dorkusprime/miata-remote-control-knob/hardware/sony-remote/pad-map.md

# Sony interface pad allocation

The [component placement image](placement-full.svg) shows the top and horizontally mirrored underside. See the [bench results](../../docs/bench-results-2026-11-05.md) for observed hardware behavior and the [circuit guide](../../docs/sony-interface.md) for installation limits.

## Component terminals

| Ref | Part / side | Terminal → pad |
| --- | --- | --- |
| U1 | MCP41050-I/P / top | 1 → E1, 2 → E2, 3 → E3, 4 → E4, 8 → F1, 7 → F2, 6 → F3, 5 → F4 |
| U2 | SN74HCT125N / top | 1 → E6, 2 → E7, 3 → E8, 4 → E9, 5 → E10, 6 → E11, 7 → E12, 14 → F6, 13 → F7, 12 → F8, 11 → F9, 10 → F10, 9 → F11, 8 → F12 |
| K1 | LCC110 / top | 1 → E14, 2 → E15, 3 → E16, 4 → E17, 8 → F14, 7 → F15, 6 → F16, 5 → F17 |
| Q1 | 2N3904BU / top | E → B12, B → B13, C → B16 |
| R1 | 330 ohm / top | 1 → C15, 2 → F13 |
| R2 | 1 kohm / top | 1 → A5, 2 → A13 |
| R3 | 2.7 kohm / top | 1 → J5, 2 → J17 |
| R4 | 47 kohm / top | 1 → C7, 2 → C6 |
| R5 | 47 kohm / top | 1 → C10, 2 → C9 |
| R6 | 47 kohm / top | 1 → H11, 2 → H10 |
| R7 | 47 kohm / top | 1 → C13, 2 → C12 |
| C1 | 100 nF / top | 1 → J1, 2 → J4 |
| C2 | 100 nF / top | 1 → I6, 2 → I10 |
| C3 | 10 uF / top | + → J6, - → J10 |
| R8 | 47 kohm / top | 1 → H8, 2 → H7 |
| R9 | 47 kohm / top | 1 → G9, 2 → G7 |

## Underside header pins

J1 lands in columns B and I; J2 lands in column H. Insert header pins from underneath and solder their tails from the top. Use individual pins at spaced pads and a two-pin header at H4–H5. Use the [consolidated jumper image](../internal-jumpers.svg) for the seven J1 wires to the XIAO breakout. J1.7 at B9 is spare ground. Sony Input 2 stays insulated.

| Contact | Net | Pad |
| --- | --- | --- |
| J1.1 | GND | B4 |
| J1.2 | +5V | I1 |
| J1.3 | SCK_IN | B10 |
| J1.4 | MOSI_IN | I11 |
| J1.5 | CS_IN | B7 |
| J1.6 | RELAY_EN | B5 |
| J2.1 | SONY_IN | H5 |
| J2.2 | GND | H4 |
| J1.7 | GND | B9 |
| J1.8 | CAMERA_REQUEST | I8 |
| J2.3 | CAMERA_BUFFER | H9 |

## Camera output cable

J2.3 at H9 is the buffer output. Insert R10 (1 kohm) in series in this pigtail, sleeve both joints and the resistor, then connect to EXT IN 1. R10 is outside the board geometry model. Never connect this lead to vehicle 12 V.

## Underside wire pieces and bus taps

Crossings are not junctions. Use insulated wire; route clear of resistor bodies and keep leads sleeved over unrelated pads. Coordinates are endpoint and routing references, not validated three-dimensional wire bends.

| Wire | Net | Solder pads in order |
| --- | --- | --- |
| BG1 | GND | C4 → G4 |
| BG2 | GND | D4 → D6 |
| BG3 | GND | A6 → A9 |
| BG4 | GND | D9 → A12 |
| BG5 | GND | D12 → G10 |
| BG6 | GND | B6 → I7 |
| BV1 | +5V | G1 → H6 |
| BV2 | +5V | G6 → G13 |
| W10 | CS_OUT | A1 → A8 |
| W11 | SCK_OUT | B2 → B11 |
| W12 | MOSI_OUT | C3 → J12 |
| W13 | PW | H3 → G16 |

Use one insulated through-hole jumper per listed pair. Each end has its own hole.

## Assembly and physical conditions

- Fit sockets and top components first, without solder. The IC-only image is now a subset of this candidate.
- R1 and R4–R8 stand upright. R1 is at C15 and its sleeved return lead follows the gap between U2 and K1 to F13. The power bus now ends at G13. This is a formed-lead proposal, not a validated socket clearance or guaranteed supplied lead length.
- Q1 has a formed-lead footprint, not the default three adjacent TO-92 holes. E=B12, B=B13, C=B16. Q1 moves to the lower-left corner; R7 runs straight along C12–C13. Check the actual part orientation and preform without force at the body.
- All component bodies are now on top. R2 follows the top left edge; R3 follows the top right edge with a jog to x=37 mm past C3. Sleeve extended leads and dry-fit before trimming.
- Check supplied lead lengths before trimming. If a lead cannot follow its proposed route safely, revise the model or use an insulated extension; do not force the component.
- C1/C2 leads are spread to the listed pads, rather than matching the stock 2.5 mm lead pitch. Avoid stress at the ceramic coating. C3 is polarized.
- Body envelopes are provisional. The resistor envelope allows 6.8 × 2.6 mm, based on Yageo MFR-25 maximum body dimensions. Socket outlines, capacitor lead availability, mounting-hole locations and assembled height still require actual measurements.
- All component bodies are on top; only the 12 wire pieces and solder joints are underneath. Distributed pigtails preserve the no-cut board. Mounted height and center mounting-hole access remain unverified.
- On the actual board, verify A–E / F–J strip continuity and orientation first. Do not solder until the dry-fit and receiver-disconnected electrical checks pass.

## Verification scope

`python3 scripts/full-placement.py --check` verifies the 16 board component references, terminal connectivity against an independent device-pin contract, all resistor values, factory strips, no accidental net joins, no reused holes, pigtail assignments, nominal body separation, all-top component placement, orthogonal routes, and all component-lead routes avoiding other component bodies. It also verifies that the SVG/table match the model. This is not a timing, analog-current, power-sequencing or physical-fit simulation.

Regenerate with `python3 scripts/full-placement.py`. Tests deliberately introduce a rail short, an open jumper, a transistor-pin swap, pad reuse, a resistor-value error, a body overlap a missing bus tap, a diagonal wire, and a component lead crossing another body.

Source for resistor envelope: [Yageo MFR datasheet, dimensions](https://yageogroup.com/content/datasheet/asset/file/YAGEO-MFR_DATASHEET). Other envelopes are conservative drawing assumptions, not new manufacturer guarantees.
