dorkusprime/miata-remote-control-knob/docs/tasks.md

# Development checklist

## Workspace

- [x] Verify local commits, GitHub push, remote branch, and clean working tree (2026-10-26).
- [x] Choose and pin a firmware toolchain/core and Twist library (see firmware/toolchain.json; 2026-10-27).
- [x] Confirm XIAO USB enumeration (Seeed XIAO RP2040, /dev/cu.usbmodem1412301; 2026-10-27).
- [x] Compile serial-only diagnostic for XIAO; no compiler warnings (2026-10-27).

## Encoder diagnostics and follow-up: Sony disconnected

Initial functional diagnostic complete: USB/I2C, rotation, button, RGB, and repeated Picotool uploads are verified by user observations. Gesture implementation and installation checks remain separate.

- [ ] Dry-fit headers, cable plugs, and enclosure clearances.
- [ ] Verify wiring continuity and absence of shorts while unpowered.
- [x] User uploaded the first serial diagnostic via BOOT-mode UF2 copy (2026-10-27).
- [x] User uploaded and tested diagnostic v2; rotation/buttons/held rotation confirmed in supplied serial output.
- [x] Build Picotool-enabled firmware and add build/upload helper (2026-10-27).
- [x] User installed Picotool-enabled build; subsequent Picotool uploads succeeded (2026-10-27).
- [x] User confirmed two successive USB uploads without button access or unplugging (2026-10-27).
- [x] Verify Twist at 0x3F: working v2 snapshot reads require that address and expected device ID. A separate scan transcript was not supplied.
- [x] Button DOWN/UP events observed by user (2026-10-27).
- [x] V2 reads rotation in both directions and while pressed (user serial output; 2026-10-27). Original diagnostic failure cause remains unconfirmed.
- [x] User reports RGB diagnostic tests worked after r/g/b/o test instructions (2026-10-26, client local date).
- [x] Preserve original diagnostic; implement separate gesture controller with serial-only command output.
- [x] Add live translated monitor with port detection and reconnection.
- [x] Pass 19 host gesture scenarios and 15 monitor tests, including virtual serial testing (2026-10-26 client local date).
- [x] User uploaded controller and reports all gestures functional through the live monitor (2026-10-26 client local date).
- [x] Implement full-brightness idle blue and nonblocking gesture LED feedback, including camera acknowledgement pulse only.
- [x] Pass 10 LED scenarios and compile controller v2 (2026-10-26 client local date).
- [x] User uploaded LED build and reports all feedback working (2026-10-26 client local date).
- [ ] Confirm repeat Picotool uploads with the controller sketch.

## Sony interface

- [x] User powered Sony successfully from bench supply at nominal 12 V (2026-10-28).
- [ ] Record supply model/rating, current limit, startup current and loaded voltage; previous supply-collapse cause unknown.
- [x] Included steering-remote adapter is on hand: Input 1, Input 2, ST Remote GND (user observation recorded 2026-10-27).
- [ ] Confirm adapter model and which remote input to use; verify plug-contact mapping if needed.
- [x] Measure remote input unloaded and with known load: approximately +3.3 V, 9.86 kohm load, 2.939 V loaded (2026-10-28).
- [x] Record actual steering-learning menu: ten functions including Mute, no camera assignment; see bench report.
- [ ] Test passive resistor commands/learning; a loaded voltage measurement is not command recognition.
- [x] Archive five-relay ladder; select one LCC110 plus digital pot (user direction, 2026-10-27).
- [x] Select MCP41050-I/P + SN74HCT125N + existing LCC110 and NPN driver; all through-hole.
- [x] Document pin-level circuit, current limits, harness, calibration and acceptance procedure.
- [x] User ordered DigiKey components, including intentional spares (2026-10-27).
- [x] Consolidate active docs and archive superseded build instructions.
- [x] Choose a small soldered protoboard near the Sony (prior user decision).
- [x] Receive parts and assemble permanent board; replaced defective LCC110 after diode comparison.
- [x] Add a provisional current-design DIP placement image with pin/net reference; not a complete routed layout.
- [x] Place every component and pigtail in a complete proposed pad map; document top / underside views and check all nets, holes and nominal body separation.
- [x] Simplify placement: all component bodies on top, with two tapped buses and four signal wires underneath; all drawn lead and wire routes orthogonal.
- [ ] Dry-fit actual components, sockets, mounting holes, formed leads and bus construction; verify insulation, clearances and overall height.
- [x] Assemble permanent board; user verified rails, continuity corrections and relay LED current.
- [x] Implement interface diagnostic; user verified GPIO outputs and pot codes 64/128/192.
- [x] Measure and record all six calibrated output resistances with Sony disconnected.
- [ ] Validate simulated-input current, reset/fault behavior and both supply-loss orders.
- [x] Estimate Sony source impedance from user measurements: about 1.1–1.2 kohm; see bench report.
- [x] Replace the colliding initial profile with the final Sony-learned codes 0, 215, 230, 238, 248 and 255. The measured minimum is 3.047 kΩ at code 255. Endpoint current remains open.
- [x] Verify Sony learning and recognition of all six final commands at the final normal pulse timing.
- [ ] Validate final cable length, connector orientation, mounting and strain relief.
- [ ] Repeat electrical acceptance after permanent assembly.
- [x] Implement controller v3 bounded pulse queue, fault release, watchdog and real requests; host-tested/compiled.
- [x] User uploaded v4.0 and verified the integrated knob and Sony functions.
- [ ] Repeat software-only uploads through the enclosure panel jack, including after cold startup.

## Camera and installation

Required scope: [Camera 1 hardware/firmware plan](camera-control.md).

- [x] Integrate spare HCT125 camera channel, R8/R9 pull-downs and inline R10 into checked layout/BOM/docs.
- [x] Route D2/GPIO28 through internal J1.8 to the buffer and external P1.7 to EXT IN 1. P1.8 is reserved for D3.
- [ ] Verify final connector orientation and cable fit in the vehicle.
- [x] Implement camera-request backend and host fault-release tests.
- [x] Verify external-source EXT IN 1 assertion and release to previous screen (2026-10-28).
- [ ] Test touchscreen Back/retrigger and repeat release with actual buffer.
- [ ] Provide camera power during manual preview, independent of reverse-lamp-only power.

- [ ] Identify actual camera/DVR model and supply requirements.
- [x] User confirmed Camera 1 without camera-generated lines, rear input with Sony guidelines, and reverse priority in sequential-input bench test (2026-10-28).
- [x] User tested passive RCA split: reverse with lines and Camera 1 without lines, switching successfully with no reported image-quality degradation (2026-10-31).
- [x] User verified external 5 V/resistor Camera 1 trigger assertion/release, live picture, and reverse priority (2026-10-28).
- [x] Verify the assembled buffer drives manual Camera 1 on/off and Sony reverse overrides it.
- [x] Verify normal cold startup on the 12 V bench supply with the laptop unplugged.
- [ ] Measure loaded trigger voltage/current and record reverse-exit screen with a standing manual request.
- [ ] Measure lighter opening and rear clearance.
- [ ] Finalize mechanical support, power protection, and strain relief.

## Bench evidence and next session

The [November 12 bench record](bench-results-2026-11-12.md) is the current status and links the earlier measurements and fixes. The milestones below preserve the development history, including test plans that later versions superseded.

## Historical implementation milestone — 2026-11-06

See [assembled bench results](bench-results-2026-11-05.md) and [controller v3 workflow](gestures.md). Historical checklist descriptions above are evidence of earlier plans, not a reason to repeat already completed strip-continuity tests. At that stage, Sony learning, integrated physical behavior and power-loss acceptance were open.

## Learning mode — 2026-11-06

- [x] User uploaded integrated controller and reported knob/LED operation working.
- [x] Implement ten-second knob hold entry/exit, LED flash feedback and three-second learning holds; host testing and compile recorded in gestures.md.
- [ ] User uploads v3.2 and verifies Sony Custom learning/recognition; 55 ms learning attempt did not register.

## Current Sony calibration — 2026-11-06

- [x] User confirms Sony distinguishes code 0 / Volume Down and code 255 / Volume Up.
- [x] Restore three interior steering candidates spaced by estimated input voltage, retaining both endpoint codes.
- [x] Add RAM-only serial assignment changes and raw six-second probes; no reflashing needed per trial.
- [ ] User uploads v3.4 and tests Mute first, then Next/Previous; record distinct/colliding/ignored responses.
- [ ] Map recognition boundaries relative to learned assignments and establish the usable number of distinct commands.
- [ ] Verify ordinary short-pulse operation for accepted commands, repeat software upload after cold startup, and complete power-transition acceptance.

This current status supersedes older pending endpoint and initial learning-mode upload items; those historical entries retain their original context.

## USB host compatibility — 2026-11-06

- [x] Research upstream reset failures through their resolution and inspect actual local tool/library versions.
- [x] Replace macOS uploader dependency Picotool 2.0.0/libusb 1.0.27 with pinned official 2.3.1/1.0.30 bundle; no firmware change or agent flash.
- [ ] User retries upload with the corrected host bundle, then repeats after successful programming; actual software-reset reliability remains unverified.

## Standard upload baseline — 2026-11-06

- [x] Record that Picotool/libusb upgrade alone did not resolve the user's failed software reset (zero-byte status response).
- [x] Replace custom upload orchestration with Arduino CLI's core-provided Picotool recipe; retain memory reporting and explicit port selection.
- [ ] User verifies initial, repeat and post-power-cycle upload without pressing BOOT. This is required before burial behind the console fascia.

## Sony learning progress — 2026-11-06

- [x] User confirms v3.4 loaded and three commands functional: Volume - (0), Play/Pause via single press (238), Volume + (255).
- [x] User taught Next Track via held right turn (248) and Previous Track via held left turn (215); all five commands work.
- [x] Stop capacity exploration at user request: nine codes accepted, ample capacity for six requested audio commands. Maximum remains unknown.

## Final requested controls — controller v3.5

- [x] Preserve Volume +/-, Play/Pause, Next/Previous and separate Camera 1 double-click output.
- [x] Add stationary hold/release Mute using Sony-accepted code 230; distinguish `play_pause` from `mute_att` in firmware and monitor.
- [ ] User uploads v3.5 and verifies hold/release Mute, other gestures and Camera 1 operation. Existing Sony assignments can remain.
- [ ] Complete reliable software upload and power-transition acceptance before installation.

## Knob responsiveness — v3.6

- [x] Identify measured fast-roll drops as firmware queue-capacity and age-expiry policy, not button debounce.
- [x] Preserve consecutive volume detents using counted runs; user trace confirms all 17 steps transmitted.
- [x] Add RAM-only normal pulse/gap timing adjustment and retain output timestamp diagnostics.
- [ ] Test shorter pulses against Sony, starting with `timing 25 25` and one detent, then tune for usable fast-roll response. Default remains 55/55 until a faster rate is validated.

## Live-volume candidate — v3.7

- [x] Record unacceptable counted-FIFO lag at 55/10 and missed Sony commands at 25/10.
- [x] User verifies Sony repeats volume during a six-second held command.
- [x] Implement slow-detent taps plus rapid-turn holds with 100 ms idle release and reversal cancellation; host tests and build pass.
- [ ] User verifies slow-step precision, short fast-roll usefulness, prompt stopping and reversals on Sony. Initial receiver repeat delay remains unmeasured.

## Coarse fast-flick candidate — v3.8

- [x] Record that a 188 ms live hold yielded one step and 25/55 timing failed recognition.
- [x] Implement fine one-step turns and coarse ten-step fast flicks without repeated-burst accumulation.
- [x] Support `timing PRESS GAP [BOOST_STEPS]`; invalid values preserve output state and timing report includes enabled/suspended state.
- [ ] User uploads v3.8 and tests `timing 55 10 10`, then tunes coarse size and timing. Full-burst recognition and desired feel remain pending.

## Proportional response — v3.9

- [x] Record user-reported 30/30 recognition and rejection of fixed ten-step bursts for small fast turns.
- [x] Restore one output pulse per detent, counted volume runs and two-number timing configuration, with 30/30 defaults.
- [ ] User verifies a fast three-detent turn produces three Sony steps and assesses larger rolls at tuned timing. Physical recognition and acceptable tail remain hardware acceptance items.

## Explicit bulk gestures — v4.0

- [x] Implement mirrored L–R–L / R–L–R detection with configurable first/second min/max detents, third minimum, gap, whole-pattern window, quiet interval and target magnitude.
- [x] Trigger immediately; consume final-flick tail; reverse interrupts immediately and fresh same-direction motion interrupts after quiet.
- [x] Replace volume queue using signed committed-pulse accounting; finish active pulse and preserve its gap, unrelated queued commands and camera state.
- [x] Preserve ordinary proportional behavior for unsuccessful patterns and bypass detection for learning/held-track gestures.
- [x] Add console tuning, recognition/tail reporting, purple recognition feedback and host tests. Tuning is RAM-only during trials.
- [x] User verified normal operation on Sony with v4.0. Traces confirmed four pulses for four ordinary detents, both ten-step bulk directions and mid-burst interruption. Exact Sony display counts were not recorded.
- [ ] Retain selected tuning values across power cycles once settled (current trial values reset on reboot).
