dorkusprime/miata-remote-control-knob/docs/interface-diagnostic.md

# Interface bench diagnostic

The interface sketch controls the assembled MCP41050/HCT125/LCC110 board through the [seven internal jumpers](wiring.md#internal-jumper-wires). Use it with the Sony and all external signal sources disconnected.

## Build and upload

Run from the repository root.

```sh
scripts/knob.sh build interface
scripts/knob.sh upload interface
```

The user performs the upload. Picotool maintenance and the upload size report use the same tooling as the existing sketches.

For initial upload, leave the interface harness disconnected. Turn off and disconnect the bench supply from the interface. Then connect the internal jumpers per the [hookup guide](wiring.md#internal-jumper-wires). Power the XIAO and interface together through laptop USB, with interface +5 V supplied from XIAO VBUS. Twist remains on 3V3. Use one 5 V supply path.

Open an interactive 115200-baud serial terminal. The existing raw monitor is available with the actual port:

```sh
scripts/knob.sh raw-monitor /dev/cu.usbmodemYOURPORT
```

Send each command followed by Enter. The gesture monitor parses a different protocol.

## Commands

| Command | Behavior |
| --- | --- |
| help | Print commands and bench conditions |
| status | Print requested pot code, arm state and output states |
| arm bench | Release outputs and enable commands for 60 seconds |
| pot 128 | Release outputs and write a decimal pot code from 0 through 255 |
| relay | Release other output, then assert relay drive for 10 seconds |
| camera | Release other output, then assert camera request for 10 seconds |
| release | Release both outputs and disarm |
| boot | Release outputs, disable watchdog and enter USB BOOTSEL for maintenance |

The diagnostic requests code 128 initially. It initializes SPI and programs that code when first armed. Writes use SPI mode 0 at 100 kHz with command byte 0x11. CS is D0/GPIO26, clock D8/GPIO2, MOSI D10/GPIO3, relay D1/GPIO27 and camera D2/GPIO28. D9/GPIO4 is configured as an unused SPI MISO input.

Invalid commands, input overflow, serial disconnect and arm expiry release both outputs and disarm. A five-second watchdog resets stalled firmware while bench commands are armed. Disarming disables it. Cold startup services USB maintenance before SPI initialization. Hardware pull-downs provide reset defaults. Each output assertion ends after ten seconds. SPI transactions and USB prints are bounded under normal core operation. Physical power-transition behavior still requires electrical acceptance.

Serial status describes software requests. Measure actual outputs and resistance to confirm device operation. MCP41050 has no SPI readback.

## First check

Send `status`. Expect ready=0, armed=0, pot_requested=128, relay_requested=0 and camera_requested=0. Measure H9 to B4 in DC volts and expect approximately 0 V.

Subsequent checks proceed one at a time. Relay contacts and pot resistance can be checked with a known current-limited source and voltage measurements. Check the meter's resistance-mode test voltage/current before using ohms mode on powered analog terminals. Continue to [assembly acceptance](assembly-and-test.md) for voltage, current and power-sequencing limits.

Microchip reference: https://ww1.microchip.com/downloads/en/DeviceDoc/11195c.pdf

## Historical custom USB upload recovery (retired)

Current uploads use Arduino CLI directly through `knob.sh`; see the [current workflow](../firmware/README.md#current-upload-workflow--arduino-cli). The custom uploader described in this section was removed after repeated failures.

The upload helper detects the sole matching RP2040 serial device, requests BOOTSEL using the pinned core’s 1200-baud serial reset sequence, and retries Picotool ROM access for up to 12 seconds while USB re-enumerates. It holds DTR low after selecting 1200 baud and allows USB re-enumeration. If serial reset does not expose ROM mode, it requests a separate Picotool USB reboot before retrying the load. Close serial monitors before uploading. With no serial device, it tries an already-present BOOTSEL device once. Multiple matching serial devices are rejected before reset. This recovery is unit-tested with mocked USB operations. The user verified repeat flashing and flashing after unplug/replug with the interface firmware.

The uploader first sends status at 115200 baud. When the interface diagnostic identifies itself, the uploader sends boot, which disables the watchdog before entering ROM mode. A second upload passed before power cycling, but generic resets failed after unplug/replug. The user subsequently verified cold-start uploading through this application-command path. Controller v3 retains the same commands; repeat with that build.

### Missing serial versus USB recovery — 2026-11-06

The user again saw an upload failure with no serial reboot line. Read-only Arduino board listing showed only the host's Bluetooth/debug ports, and `picotool info -a` reported no accessible BOOTSEL device. The generic close-monitor message did not distinguish this condition. An earlier full power cycle had not restored the Twist; its specific initialization-failure cause is still pending the diagnostic upload.

The uploader now checks a failed Picotool load report for a single runtime RP2040/RP2350 USB device even when no serial port exists, and may request the existing USB reboot path in that case. Multiple reported runtime devices are rejected before reset; absence of both serial and a reported runtime/ROM target stops with an explicit detection error. It does not blindly force-reset devices or claim to repair a host enumeration failure. Eight mocked uploader tests passed. No live reset/upload was performed by the agent. A known data-capable replacement USB cable is the next proposed hardware check.

### Explicit USB detach before controller BOOTSEL — 2026-11-06

The next user upload found `/dev/cu.usbmodem1101` but received no application status response. The 1200-baud reset and Picotool reboot request did not expose ROM mode; Picotool still reported a runtime serial device. Read-only board listing afterward showed that same serial device; `lsof` reported no owner. An attempted agent-side status read was blocked by the session's device-access sandbox, so it supplied no additional evidence about application responsiveness.

Controller v3.3.1 replaces the immediate `reset_usb_boot` command with a deferred request: release outputs/disable watchdog, stop processing other serial commands and peripherals, wait at least 100 ms for the host to close CDC (one-second fallback for a terminal that remains open), call the pinned core's `USB.disconnect()` in loop context, then enter ROM. The core method explicitly detaches USB and, when connected, allows 500 ms for host detection. No USB reset from an interrupt handler or private core patches are added.

The uploader now asserts DTR/RTS before opening, allows 250 ms for line state readiness, collects fragmented status responses across reads for up to roughly four seconds, and closes immediately after flushing `boot` rather than holding the port open for another 300 ms. Re-enumeration retry follows closure. The existing diagnostic sketch retains its original immediate boot behavior; this firmware change applies to the integrated controller.

Rationale: [Arduino-Pico issue 3240](https://github.com/earlephilhower/arduino-pico/issues/3240) reports sensitivity to reset/detach timing on a different Linux/hub configuration and discusses explicit TinyUSB detach. This is supporting evidence for a recovery experiment, not proof that the Mac has the same cause. The software changes need an initial successful recovery upload and then repeated software uploads/cold-start testing. BOOTSEL has consistently worked by user report; the cable/port have previously transferred data. No live reboot/upload was performed by the agent.

Verification for v3.3.1: pinned XIAO build passed (88,496-byte flash image; 10,008-byte static RAM). Passed 24 gesture, 12 LED, 13 output-driver, three USB-maintenance timing scenarios and 58 Python tests, including fragmented status identification. Initial core rebuild emitted its two previously recorded USB.cpp initializer warnings; no sketch warnings. Final `git diff --check` passed. These are software checks, not proof that the intermittent USB failure is fixed on hardware.

## macOS host-tool investigation — 2026-11-06

The user again reported the full sequence: a matching `/dev/cu.usbmodem1101`, no interface status response, unsuccessful 1200-baud reset, Picotool claiming it asked for BOOTSEL, and a subsequent load still reporting a runtime device. This does not establish whether ROM was never reached, briefly reached, or was hidden by host re-enumeration failure. A reboot request message is not a successful reboot acknowledgment. Manual BOOT uploads have repeatedly worked, including when software uploads failed.

Read-only inspection found:

| Item | Observation |
| --- | --- |
| macOS | 26.6.2, build 25G83 |
| Actual bundled Picotool | 2.0.0, despite Arduino package label 5.0.0-9576866 |
| Actual adjacent libusb | 1.0.27.11882, queried using `libusb_get_version` |
| Runtime USB registry | XIAO RP2040, VID:PID 2e8a:000a; serial device exists |
| Open serial owner | `lsof` reported none at inspection time |
| Agent status-only read | Blocked by device sandbox (`Operation not permitted`); no inference about firmware responsiveness |
| Application build | Correct XIAO FQBN with `uploadmethod=picotool`; compile-time check requires USB reset interface |

The official [libusb changelog](https://github.com/libusb/libusb/blob/master/ChangeLog) records a macOS 26 Tahoe compatibility repair in **1.0.30**, specifically port-number lookup after Apple changed `kUSBHostPortPropertyPortNumber`. That is a concrete compatibility defect in our old host dependency, but port-number repair alone is not proof of the cause of silent CDC or failed reset. The official [Raspberry Pi host tools release](https://github.com/raspberrypi/pico-sdk-tools/releases/tag/v2.3.1-0) provides Picotool 2.3.1; its macOS archive was downloaded, checked against the release SHA-256, and inspected. It bundles libusb 1.0.30. Both versions were executed/queried locally without resetting or flashing hardware.

The uploader now uses this separate pinned host bundle on macOS. The existing firmware reset path remains unchanged, providing a controlled comparison. Its initial log identifies actual host-tool versions. When CDC does not identify the firmware, the uploader reports how many bytes arrived and an escaped bounded sample, distinguishing silence from an unexpected response. No automatic upload acceptance is claimed; the user must retry the same upload, then repeat after success.

Other upstream reports were checked through their conclusions:

- [Arduino-Pico #3240](https://github.com/earlephilhower/arduino-pico/issues/3240) closely matches manual-BOOT success/software-reset failure. Its author ultimately traced their failure to a **Linux USB hub/host interaction when the serial handle remained open** and closed it as not an Arduino-Pico bug. A suggested `tud_disconnect` change did not solve that case. It is relevant evidence about reset/handle ordering, not proof that our Mac has the same bug or a reason to apply an unmerged core patch.
- [Picotool #56](https://github.com/raspberrypi/picotool/issues/56) was resolved by including firmware USB reset support. Our build already enables that support.
- [Arduino-Pico #2078](https://github.com/earlephilhower/arduino-pico/issues/2078) concerns older Picotool's hardcoded VID/PID handling of third-party boards. Our observed runtime identity is already 2e8a:000a and the old tool reported it, so that report does not explain the entire present failure.

If the corrected host bundle still fails, the unresolved branch is **CDC unresponsiveness versus USB mode transition**, not another blind delay tweak. Record the new tool/version line and received-byte count before choosing further firmware changes. Do not erase flash, change wiring, or attribute this to the known-capable cable without additional evidence.

Verification: pinned archive SHA-256 matched `7bb3cea5d9f1b000fc758cf4b54774fda5c16a9899d342ef6b0c30138988793b`; actual executable reported 2.3.1 and adjacent library reported 1.0.30. The host suite passed 24 gesture, 12 LED, 17 Sony-output, 3 USB-maintenance scenarios and 64 Python tests, including rejection of a pre-Tahoe library, archive checksum enforcement, exact-member extraction and version-only verification. Shell/Python syntax and `git diff --check` passed. No firmware rebuild was necessary because no sketch source changed. No agent reset, upload or power transition was performed.

## Standard Arduino CLI upload baseline — 2026-11-06

The user retried the corrected Picotool 2.3.1/libusb 1.0.30 bundle. The custom uploader received **0 bytes** in response to `status`, then failed to reach accessible BOOTSEL through both its 1200-baud and separate Picotool reset attempts. The host-library update was insufficient. Because the status signature was absent, the custom firmware `boot` command was not sent, so its deferred detach logic was not exercised by that attempt.

The user requested the accepted Arduino workflow because pressing BOOT after console installation is untenable. `knob.sh upload` now invokes Arduino CLI `upload --fqbn ...:uploadmethod=picotool --input-dir ... --verbose` using the installed core recipe. The local platform.txt recipe is `"{cmd}/picotool" load "{build.path}/{build.project_name}.uf2" -f -x`. On macOS the executable-directory property selects the already-installed current host bundle; no upload-pattern override is made. The custom serial exchange, 1200-baud fallback, separate reboot request and retry orchestration are removed. Firmware and the existing compiled image are unchanged.

Port discovery uses Arduino CLI's board list and matches the XIAO FQBN. An explicit `--port` bypasses auto-selection; multiple matching ports stop before invoking upload. No serial port is required when the core's Picotool can discover USB directly. Picotool itself selects its USB target independently of the serial port, so use only one intended RP target for the baseline test.

User test: close monitor; run `scripts/knob.sh upload controller`. Preserve verbose output if it fails. If it succeeds, repeat without touching the board, then verify after normal power cycling. The cause of the earlier failure is still unconfirmed; moving to the standard recipe is a controlled comparison, not a claim that native USB recovery is now solved.

Verification: seven wrapper integration tests used a fake Arduino CLI and fake artifacts, with no device access. They cover exact core/FQBN/artifact arguments, the executable-directory override, automatic and explicit port selection, multiple-port refusal, no-serial delegation, other sketches, paths containing spaces, argument rejection and preserving CLI failure without retry. The complete host suite passed 62 Python tests plus 24 gesture, 12 LED, 17 output and 3 USB-maintenance scenarios. `git diff --check` and shell syntax passed. No firmware was flashed and no reset request was sent by the agent.

## Correct CLI tool-property scope — 2026-11-06

The user's first standard-CLI attempt exposed an implementation error: although our version banner checked Picotool 2.3.1/libusb 1.0.30, the actual verbose upload command invoked the Arduino package's Picotool 2.0.0. The override `--upload-property tools.picotool.cmd=...` did not replace the selected tool's already-flattened `cmd` property. The command also reported an empty serial number while tracking reboot. This test therefore does not establish the result of standard direct `load -f -x` using the current host bundle.

Changed the override to **`--upload-property cmd=...`**, preserving the core-provided upload pattern. The [Arduino platform specification](https://docs.arduino.cc/arduino-cli/platform-specification/) documents that selected tool properties are available without their `tools.TOOL_ID.` prefix. More importantly, the correction was verified against the **actual installed Arduino CLI and core**, using its supported hidden `--dry-run` switch and a nonexistent port. The resolved command now points to `.tools/picotool-host/picotool`, followed by `load <controller.ino.uf2> -f -x`. No uploader process or attached-board reset was executed. The wrapper exposes `--dry-run` for repeatable inspection.

Added a real-CLI regression test asserting the resolved executable is the pinned host bundle and that the obsolete bundled-tool directory is absent. Earlier fake-CLI wrapper tests only checked argument forwarding, which did not catch the property-scope mistake. User hardware upload with this corrected command remains pending.

## Corrected standard upload: USB device absent — 2026-11-06

The user's next attempt printed the correct `.tools/picotool-host/picotool` executable path and ran the standard `load ... -f -x` recipe. Arduino CLI found no matching serial port, and Picotool reported no accessible BOOTSEL device without reporting a runtime device or issuing a reboot request. No firmware transfer occurred.

Immediate read-only inspection confirmed that Arduino CLI listed only Bluetooth/debug ports; macOS `SPUSBHostDataType` contained no XIAO/RP-series device, `/dev/cu.usb*` had no nodes, and no RPI BOOTSEL volume was mounted. This is broader than an unanswered application serial command: the device is absent from host USB enumeration. These observations do not distinguish a failed transition/host USB state from a physical disconnection or loss of board power. No cable fault is established.

Next controlled recovery: disconnect/reconnect at the accessible laptop USB end normally, without pressing BOOT, then retry the same standard upload. The purpose is fresh USB attachment; if the board has another power source this does not necessarily reset its processor. Agent performed no hardware reset or upload. Reliable software-only updating remains unverified.
