dorkusprime/miata-remote-control-knob/hardware/archive/sony-remote-photomos/README.md

# Archived five-PhotoMOS interface

**Superseded; do not build or use these connector allocations.** This isolated-ground AQY212EH ladder differs from the selected shared-ground MCP41050 design.

Use the [current circuit](../../../docs/sony-interface.md) and [current hardware index](../../sony-remote/README.md).

The historical JSON, schematic, placement and BOM are retained together. Regenerate from the repository root with `python3 scripts/sony-interface.py`; verify with `python3 scripts/sony-interface.py --check`. Host tests exercise this historical netlist only; they do not validate the current circuit.
