dorkusprime/miata-remote-control-knob/hardware/sony-remote/bom.csv

Reference | Quantity | Part | Specification
U1 | 1 | MCP41050-I/P | 50 kohm DIP-8
U2 | 1 | SN74HCT125N | DIP-14 TTL-input buffer
K1 | 1 | LCC110 | DIP-8 normally-open contact pins 5/6; existing
Q1 | 1 | 2N3904BU | TO-92 NPN; verify E/B/C
R1 | 1 | MFR-25FBF52-330R | 330 ohm 1% 0.25 W
R2 | 1 | MFR-25FBF52-1K | 1 kohm 1% 0.25 W
R3 | 1 | MFR-25FBF52-2K7 | 2.7 kohm 1% 0.25 W
R4-R9 | 6 | MFR-25FBF52-47K | 47 kohm 1% 0.25 W
C1-C2 | 2 | K104K15X7RF5TL2 | 100 nF 50 V X7R radial
C3 | 1 | ECA-1CM100B | 10 uF 16 V radial; polarized
Sockets | 2 | Optional DIP-8 | U1 and K1
Socket | 1 | Optional DIP-14 | U2
Board | 1 | Existing prototype board | Permanent ElectroCookie Mini fit pending
Harness | 1 | Eight-conductor removable cable | See docs/wiring.md; not historical pin allocation
R10 | 1 | MFR-25FBF52-1K | 1 kohm 1% inline in insulated camera pigtail
