dorkusprime/miata-remote-control-knob/docs/bench-results-2026-11-05.md

# Interface board bench checks — 2026-11-05

For the assembled-box and end-to-end follow-up, see the [November 12 bench record](bench-results-2026-11-12.md). Pending items below describe the stage at which they were recorded.

The assembled board was tested with the XIAO and Sony disconnected. These measurements were taken before the interface diagnostic firmware was built.

| Check | Result |
| --- | --- |
| R1 | 328 ohm |
| Power-to-ground resistance, chips removed | Settled at 2.79 Mohm |
| R2 | 996 ohm |
| Clock connection | Passed after installing missing W11 |
| Data connection | Passed after moving W12 from J11 to J12 |
| Pot wiper jumper | Continuity passed |
| R3 | 2.692 kohm |
| R4/R5 | 47 kohm each |
| R6 | 46.9 kohm |
| R7/R8 | Reported good |
| R9 | 47 kohm confirmed after an inconsistent pad/probe reading |
| Supply at both IC sockets and C3 | Approximately +5 V |
| Supply with chips installed, idle | 5 V, displayed 0 A |
| Q1 base and camera output at idle | 0 V |
| R1 drop at idle | 0 V |
| Camera request driven from 5 V through temporary 1 kohm resistor | H9 output 4.98 V |
| Camera request removed | H9 output 0 V |
| Relay test Q1 base / collector | 0.726 V / 0.01 V |
| Original LCC110 diode check pins 2–3 | OL in both directions |
| Spare LCC110 diode check pins 2–3 | 1.068 V |
| Replacement LCC110, relay drive asserted | Supply displayed 13 mA at 5 V |
| Replacement LCC110, R1 drop asserted | 3.73 V |
| Relay drive removed, R1 drop | 0 V |

R1 current calculated from the measured drop and resistance is 3.73 / 328 = 11.4 mA. The original LCC110 also had a bent output leg at F17. It was replaced after the diode comparison identified an open internal LED.

Relay LED drive and camera buffer assertion/release passed. Relay contact switching, programmed pot behavior, 3.3 V MCU control, reset/fault behavior and supply-order acceptance remain to be tested.

## MCU-controlled tests — completed through 2026-11-06

The user connected the complete XIAO-to-interface harness and powered it from USB. Twist shares XIAO ground via a Y connection with board B4. B9 is a redundant ground header and remains unused. The Sony stayed disconnected.

| Check | User observation |
| --- | --- |
| USB enumeration after harness connection | Initially missing; changing laptop USB port restored it despite valid 5 V/3.3 V rails |
| Interface serial startup | `ready=0 armed=0 pot_requested=128 relay_requested=0 camera_requested=0` |
| `arm bench` | ready=1, armed=1 |
| GPIO camera test | Assert/release worked |
| GPIO relay test, R1 voltage drop | 3.865 V asserted, then 0 V; about 11.8 mA using 328 ohm R1 |
| Pot 64, relay active, H5–H4 | 43.7 kohm |
| Pot 128, relay active, H5–H4 | Approximately 30 kohm after meter settling |
| Pot 192, relay active, H5–H4 | 16.4 kohm |
| Relay timeout | Output returned to OL after ten seconds |

Resistance measurements used a Fluke 27/FM, red H5 and black H4, in a manually selected high-kohm range. The initial 50 → 28 → 30 kohm display at code 128 was a settling observation, not a measurement of command latency. Actual short-pulse timing is unmeasured. No external voltage source or Sony was connected to the analog port during these resistance tests.

These results verify relay contact switching and SPI-controlled resistance adjustment, in addition to the earlier LED-drive and buffer tests. They do not verify Sony learning, command recognition or power transitions. The two endpoint readings imply approximately 54.6 kohm full pot resistance. Pin 5 is PA and pin 7 PB, correcting earlier swapped terminal names; the physical wiring is unchanged. Output resistance decreases as code increases. Controller candidates 96/160 remain interpolated, not directly measured.

### USB cold-start recovery

The user verified the interface firmware's serial `status`/`boot` path, successful repeated upload, and successful upload after unplugging/replugging. The current controller preserves that maintenance path. That controller build has not yet been uploaded or cold-start-tested. The later host-port enumeration incident has no confirmed firmware cause.

### Next acceptance

User uploads controller v3 with Sony disconnected, checks gestures/LED and software reboot, then performs controlled Sony Custom learning of the five code assignments. Interface must be powered before Sony and remain powered until Sony is switched off for these bench checks. Power-loss orders, reset/fault timing, final camera-buffer loading, final wiring and installation remain pending.

## Integrated controller and first Sony attempt — 2026-11-06

The user uploaded controller v3 and reported the integrated knob working (gesture/LED behavior). Sony was then connected. On the Custom learning screen, Sony requested “press and hold to assign steering button”; a one-detent turn did not register. Normal firmware sends 55 ms pulses. Pulse duration is a plausible explanation, not a confirmed diagnosis; acceptance of the chosen high-resistance codes has not yet been established.

Controller v3.2 adds a ten-second stationary hold to enter/exit learning and bounded three-second assignment holds from the existing gestures. Entry: three amber flashes; idle learning: amber; assignment request: two green flashes; exit: three blue flashes. The original diagnostics remain available. User upload and Sony acceptance of this new build are pending.

## Twist discovery failure after upload — 2026-11-06

Following successful upload by switching laptop USB ports, the user supplied v3.2 monitor output showing USB maintenance running but repeated “Twist unavailable; retrying in 2s”. The controller keeps outputs disabled. Comparing v3 with v3.2 shows no changes to I2C pin selection or Twist initialization. This does not establish a hardware versus firmware cause.

Controller v3.2.1 separates discovery failures: library begin/address response (including a follow-up I2C return code, instantaneous SDA/SCL levels and timeout flag), register-pointer write, short snapshot, unexpected device ID, color setup and count-limit setup. Pin levels are diagnostic observations, not proof of wiring continuity or power. No changed I2C timing, automatic bus scanning, or new recovery mechanism is introduced. The next hardware check is a full XIAO/Twist power cycle with Sony off; diagnosis remains pending.

## Sony learning collision and endpoint-test request — 2026-11-06

The user identified a loose Twist ground connector as the cause of its no-ACK initialization failure; USB intermittency is a separate observation. With the ground secured, knob-operated learning ran. Sony accepted Volume Down for a left turn but treated other gestures as that same command, reporting “Cannot overwrite steering button assignment” when learning another function.

Loaded Input 1 measurements (H5 to H4, DC volts): idle **3.27 V**; ordinary right turn **3.19 V**; held-left initially reported 3.17 V, then corrected to **3.06 V** after allowing more settling time. The user noted that six seconds is barely enough for the meter to settle. The Sony still reported Volume Down. These observations support differing analog outputs but do not measure Sony's recognition thresholds.

At the user's request, controller v3.3 enables only two steering codes at opposite endpoints: right/Volume Up 255, left/Volume Down 0. Other steering outputs are disabled for this test. Six-second holds are retained. Estimates and wiper-current constraints are documented in gestures.md; physical endpoint/current/recognition acceptance is pending. No wiring change is requested and the agent has not flashed the board.

## Endpoint recognition and expanded calibration — 2026-11-06

After an interruption in which output did not change and learning appeared to end, the user suspected a jostled cable and then confirmed: **Sony properly distinguishes Volume Down from Volume Up** with the endpoint profile (left code 0, right code 255). This supersedes the earlier pending endpoint-recognition status. No final endpoint loaded voltages were reported, and the suspected cable event does not establish a firmware cause. Repeated software-only upload reliability remains unverified.

At the user's request to find Sony's learning limits, controller v3.4 keeps both endpoints and introduces Mute 238, Next Track 248, Prev Track 215. These are voltage-spaced estimates, not receiver-validated assignments. Serial `codes`, RAM-only `set ACTION N`, and six-second raw `probe N` allow testing boundaries without repeated firmware uploads. First receiver test: Mute between the proven endpoints. See gestures.md for procedure and limitations. No hardware was flashed by the agent.

## Three distinct Sony commands working — 2026-11-06

Following the corrected standard uploader changes and another laptop-port move, the user confirmed the firmware loaded. The user then taught Sony **Play/Pause for single-press** and reported **all three commands functional**: Volume -, Volume +, and Play/Pause. The loaded v3.4 defaults map these to codes 0, 255, and 238 respectively. No runtime reassignment was reported. The local firmware/monitor action name `mute_att` does not determine Sony's learned function; no firmware change is required for this assignment.

This establishes at least three distinguishable commands on this assembled interface. It does not establish the maximum, the widths of Sony's learning windows, or measured loaded voltages for the new profile. Next test: held right turn / Next Track at default code 248; held left / Previous Track at 215 remains pending. One successful firmware load is confirmed; a second consecutive software upload on the same port has not been explicitly confirmed.

## Five distinct Sony commands working — 2026-11-06

The user subsequently taught both **Next Track** and **Previous Track** and confirmed all commands work. With the uploaded defaults, the accepted assignments are Volume - 0, Previous Track 215, Play/Pause 238, Next Track 248, and Volume + 255. This supersedes the pending Next/Previous status above and establishes **at least five** working distinct codes on this board and Sony learning configuration. No firmware update or wiring change was needed for these two assignments. This does not measure window boundaries, establish the maximum command count, or complete USB/power-transition acceptance.

Proposed next boundary/capacity trial: select an unassigned Sony function (Mute), then use console `probe 230` for a six-second raw hold, followed after release by `enable`. Code 230 lies between the accepted 215 and 238 codes, estimated near 2.88 V. This sixth code has not been tested and is not added to the gesture map.

## Learning exploration concluded; final scope — 2026-11-06

The user reported these additional learning results, after the original five working commands:

| Probe code | Sony assignment attempted | User result |
| ---: | --- | --- |
| 230 | Mute | Accepted |
| 252 | Source | Accepted |
| 244 | Voice | Accepted |
| 223 | Answer Call | Cannot overwrite |
| 128 | Answer Call | Cannot overwrite |
| 234 | Answer Call | Cannot overwrite |
| 180 | Answer Call | Accepted |

Nine distinct codes were accepted in total. Code 241/Hang Up was suggested but no result was reported. Collisions do not identify which existing assignment matched. This establishes sufficient capacity for the user's request; maximum capacity and universal recognition thresholds were not determined. The user stopped further capacity exploration.

Final scope: Previous Track, Play/Pause, Next Track, Mute, Volume +, Volume -, plus Camera 1 through EXT IN 1. Controller v3.5 preserves the five proven physical mappings and assigns accepted Mute code 230 to stationary hold/release >=700 ms and <10 s. A ten-second hold remains learning-only. Existing Sony learning need not be erased. The separate `play_pause` name replaces v3.4's misleading single-click `mute_att` name; `mute_att` now means actual Mute. No new parts/wiring. The user must upload and test the added Mute gesture; agent did not flash hardware.

## Fast-turn volume tail observation — 2026-11-06

The user reports about three seconds for volume-down activity to finish after a fast left roll and explicitly confirms the device is not in learning mode. This is an approximate user-observed duration, not a captured timing measurement. Controller v3.5.1 adds opt-in monitor display of timestamped relay GPIO changes and pending queue depth to distinguish queued output/loop delays from subsequent electrical/receiver behavior. The six-command profile, 55/55 ms pulse/gap and 750 ms expiry remain unchanged. Physical trace capture is pending the user's upload and fast-roll test; no cause is established.

## Fast-roll trace results — 2026-11-06

The v3.5.1 user trace establishes the firmware queue was dropping fast-turn inputs: a Volume Up burst requested 33 detents; 10 were accepted and 23 rejected, then only eight were transmitted before the remaining two expired. The last release was 742 ms after the last observed turn. The user subsequently clarified that “three seconds” was a rough mental estimate; the actionable issue is that the knob lag is too high to use.

The user uploaded the locally built v3.6 while workspace verification was interrupted. Their new trace shows **17 requested Volume Down detents, all 17 transmitted**, with no dropped entries. Press starts were about 111 ms apart, matching the 55/55 ms default plus settling. The final release occurred at device timestamp 29,524 ms, 1,725 ms after the last input at 27,799 ms. Volume retention now works for this burst; output serialization still causes significant lag. No shorter-pulse Sony recognition result has been reported. Next trial is live `timing 25 25`, one detent first. The host suite and compile were verified after workspace restoration; no agent flash occurred.

## Faster pulses and held-repeat result — 2026-11-06

At live timing **55/10 ms**, the user supplied a trace with 19 requested volume-down detents in approximately 110 ms and all 19 GPIO pulses serialized afterward; final release was 1,140 ms after the last observed input. They still found lag unusable. At **25/10 ms**, the user reported only a few commands recognized out of dozens. That is a receiver observation without a matching posted trace; no exact minimum pulse width is established.

The user restored 55/55 and ran the existing six-second `learn volume_down` hold outside Sony's learning screen. They reported: held command worked well, volume reached zero. This supports trying Sony's own volume repeat for continuous motion. It does not measure initial repeat delay or confirm that a short flick will repeat quickly.

Controller v3.7 implements a candidate hybrid: isolated taps, promotion to a live hold for rapid turns, 100 ms idle release, and immediate old-direction release/gapped reversal. Six controls and Camera 1 mapping are unchanged. User upload and responsiveness testing remain pending. No agent flash occurred.

## Short hold result and coarse-control intent — 2026-11-06

The user's v3.7 trace showed six isolated detents, each producing a 55 ms tap. A subsequent fast roll reported 17 detents but emitted only one hold from **113,428 to 113,616 ms** (188 ms); the receiver changed one step. This confirms that the candidate's short hold did not engage useful repeat for that flick. The user separately reported that 25/55 timing did not recognize commands. No exact minimum pulse or repeat-start delay is established.

The user clarified that a fast turn should quickly change volume by a large amount, rather than provide fine per-detent control. They requested timing adjustments via `timing` for independent tuning. v3.8 therefore implements a bounded coarse request, initially ten steps, with configurable press/gap and optional step count in that command. Multiple samples of one flick do not multiply the request; reversal and another deliberate audio action cancel the unfinished coarse work. At proposed 55/10 timing, ten pulses take about 650 ms; complete Sony recognition and usability remain unverified. Invalid timing values no longer suspend output. Source/tests/build were updated without an agent hardware upload.

## User selects proportional response at 30/30 — 2026-11-06

The user reports “30/30 works well” in current testing, but dislikes the coarse fixed burst: quickly turning three detents should not produce ten. This is a recognition/feel report, not an independently counted receiver benchmark for arbitrary bursts. v3.9 restores a proportional one-pulse-per-detent policy at all speeds and sets 30/30 as startup defaults. Fast same-direction input is counted rather than limited to eight detents or mapped to a fixed ten-step request. The two-number `timing` command, non-disabling invalid-value handling and enabled-state report remain. The former third burst-size argument is removed. User upload and three-detent physical count confirmation are pending; host regression tests cover both directions and aggregated/individual samples. No agent hardware action.

## v4.0 explicit bulk-volume gestures — 2026-11-07

User requested a separate quick L–R–L gesture for net −10 volume and R–L–R for net +10, configurable. Recognition must not pause. New input interrupts the bulk change, but continued detents from the final flick must not interrupt themselves: same-direction tail samples restart a configurable quiet interval; opposite direction interrupts immediately. Detent limits and timing thresholds are adjustable for user trials.

Implemented a signed committed-pulse ledger, cancellation of queued volume work with active-pulse completion, baseline/correction accounting, immediate three-run recognition and runtime `flick` settings. Older outstanding ordinary volume intent is included in the baseline so replacing the queue preserves it. Unrecognized patterns retain proportional behavior. Camera output, audio codes, USB maintenance and uploader remain unchanged. Two purple recognition flashes and explicit BULK/FLICK TRIGGER/FLICK TAIL monitor labels distinguish output requests from consumed input.

Initial defaults: first/second runs 1–6 detents, third minimum 1, maximum inactivity gap 250 ms, whole-pattern window 700 ms, final-flick quiet interval 120 ms, target 10 steps. Normal pulse timing remains 30/30 ms. Trial settings are RAM-only; persistence/final defaults await user selection. See [full command table](gestures.md#bulk-volume-gestures--controller-v40).

Host verification: 31 base gesture scenarios, 14 LED scenarios, 26 driver scenarios, 30 new bulk-volume scenarios, 3 USB-maintenance scenarios, 3 trace-buffer scenarios and 68 Python tests passed under the existing test runner. Bulk tests cover mirrored detection, exact signed correction, pre-existing queue intent, in-flight/settling pulses, interruption, final-flick tails, detent bounds, timeout, timer rollover, disabled/learning modes, preserving non-volume work/camera, strict parsing and live tuning. Build passed with no sketch warnings (the clean build emitted the two existing core USB driver missing-initializer warnings). Full image 93,776 bytes (4.5%); static RAM 10,872 bytes (4.1%). Agent did not flash hardware. Sony count accuracy, natural thresholds and LED feel await user testing.
