dorkusprime/miata-remote-control-knob/scripts/full-placement.py

#!/usr/bin/env python3
"""Check and draw the complete proposed MCP41050 interface pad allocation."""
import argparse
import html
import json
import math
from pathlib import Path
import xml.etree.ElementTree as ET

ROOT = Path(__file__).resolve().parents[1]
FOLDER = ROOT / 'hardware/sony-remote'
# Device-terminal contract from docs/sony-interface.md, independent of pad allocation.
PINS = {
 'U1':dict(zip(map(str,range(1,9)),['CS_OUT','SCK_OUT','MOSI_OUT','GND','GND','PW','NC_U1_7','+5V'])),
 'U2':dict(zip(map(str,range(1,15)),['GND','CS_IN','CS_OUT','GND','SCK_IN','SCK_OUT','GND','MOSI_OUT','MOSI_IN','GND','CAMERA_BUFFER','CAMERA_REQUEST','GND','+5V'])),
 'K1':dict(zip(map(str,range(1,9)),['NC_K1_1','LED_A','LED_K','NC_K1_4','SONY_R','PW','NC_K1_7','NC_K1_8'])),
 'Q1':{'E':'GND','B':'BASE','C':'LED_K'},
 'R1':{'1':'LED_A','2':'+5V'},'R2':{'1':'RELAY_EN','2':'BASE'},'R3':{'1':'SONY_IN','2':'SONY_R'},
 'R4':{'1':'CS_IN','2':'GND'},'R5':{'1':'SCK_IN','2':'GND'},'R6':{'1':'MOSI_IN','2':'GND'},'R7':{'1':'BASE','2':'GND'},
 'R8':{'1':'CAMERA_REQUEST','2':'GND'},'R9':{'1':'CAMERA_BUFFER','2':'GND'},
 'C1':{'1':'+5V','2':'GND'},'C2':{'1':'+5V','2':'GND'},'C3':{'+':'+5V','-':'GND'},
}
CONTACTS={'J1.1':'GND','J1.2':'+5V','J1.3':'SCK_IN','J1.4':'MOSI_IN','J1.5':'CS_IN','J1.6':'RELAY_EN','J2.1':'SONY_IN','J2.2':'GND','J1.7':'GND','J1.8':'CAMERA_REQUEST','J2.3':'CAMERA_BUFFER'}
RESISTORS={'R1':330,'R2':1000,'R3':2700,'R4':47000,'R5':47000,'R6':47000,'R7':47000,'R8':47000,'R9':47000}
COLORS={'GND':'#64748b','+5V':'#dc2626','CS_OUT':'#059669','SCK_OUT':'#2563eb','MOSI_OUT':'#9333ea','PW':'#d97706'}


def pad_xy(p):
    assert p[0] in 'ABCDEFGHIJ' and 1 <= int(p[1:]) <= 17, f'Invalid pad {p}'
    return (5.08+('ABCDEFGHIJ'.index(p[0])+(2 if p[0]>='F' else 0))*2.54,
            5.08+(int(p[1:])-1)*2.54)


def segment_hits_box(a,b,box,margin=0.2):
    x,y,w,h=box; lo=[x-w/2-margin,y-h/2-margin]; hi=[x+w/2+margin,y+h/2+margin]
    start,end=0.,1.
    for axis in (0,1):
        delta=b[axis]-a[axis]
        if abs(delta)<1e-9:
            if not lo[axis] <= a[axis] <= hi[axis]: return False
        else:
            t0,t1=sorted(((lo[axis]-a[axis])/delta,(hi[axis]-a[axis])/delta))
            start=max(start,t0);end=min(end,t1)
            if start>end:return False
    return True


def orthogonal(points, owner):
    assert len(points)>=2, f'Empty route: {owner}'
    for a,b in zip(points,points[1:]):
        assert abs(a[0]-b[0])<1e-6 or abs(a[1]-b[1])<1e-6, f'Diagonal route: {owner}'


def component_routes(p):
    if p.get('style')=='dip' or p['ref'] in ('U1','U2','K1'):return {}
    if p.get('style')=='transistor':return p['lead_routes']
    pins=list(p['pins'].values())
    return {'leads':p.get('lead_route',[pad_xy(pins[0]),pad_xy(pins[1])])}


def check(d):
    assert d['board']['rows']==17 and d['board']['strip_groups']==['ABCDE','FGHIJ']
    assert len(d['parts'])==len(PINS) and {p['ref'] for p in d['parts']}==set(PINS)
    parent={}
    def find(p):
        parent.setdefault(p,p)
        if parent[p]!=p:parent[p]=find(parent[p])
        return parent[p]
    def join(a,b):parent[find(a)]=find(b)
    for row in range(1,18):
        for group in ('ABCDE','FGHIJ'):
            for c in group:join(group[0]+str(row),c+str(row))
    used={}
    def occupy(p,owner):
        pad_xy(p)
        assert p not in used, f'Pad collision {p}: {owner}, {used.get(p)}'
        used[p]=owner
    for part in d['parts']:
        ref=part['ref'];assert set(part['pins'])==set(PINS[ref]),ref
        for pin,pad in part['pins'].items():occupy(pad,f'{ref}.{pin}')
        if ref in RESISTORS:assert part['ohms']==RESISTORS[ref],ref
    assert len(d['contacts'])==len(CONTACTS) and {c['ref'] for c in d['contacts']}==set(CONTACTS)
    for c in d['contacts']:
        assert c['net']==CONTACTS[c['ref']]
        occupy(c['pad'],c['ref'])
    assert len({w['ref'] for w in d['jumpers']})==len(d['jumpers'])
    for w in d['jumpers']:
        for pad in w['pads']:occupy(pad,w['ref'])
        assert len(w['pads'])>=2, w['ref']
        assert all(any(math.dist(pad_xy(p),point)<1e-6 for point in w['route']) for p in w['pads']), f'Missing tap on route: {w["ref"]}'
        assert math.dist(pad_xy(w['pads'][0]),w['route'][0])<1e-6 and math.dist(pad_xy(w['pads'][-1]),w['route'][-1])<1e-6, w['ref']
        for p in w['pads'][1:]:join(w['pads'][0],p)
    root_names={}; net_roots={}
    def label(pad,net):
        root=find(pad)
        assert root not in root_names or root_names[root]==net, f'Short: {net} / {root_names.get(root)} at {pad}'
        root_names[root]=net;net_roots.setdefault(net,set()).add(root)
    for p in d['parts']:
        for pin,pad in p['pins'].items():label(pad,PINS[p['ref']][pin])
    for c in d['contacts']:label(c['pad'],c['net'])
    for w in d['jumpers']:
        for pad in w['pads']:label(pad,w['net'])
    for net,roots in net_roots.items():assert len(roots)==1, f'Open net: {net}'
    routed_segments = []
    for wire in d['jumpers']:
        ref, route = wire['ref'], wire['route']
        assert len(wire['pads']) == 2, f'{ref}: use separate through-hole jumpers'
        orthogonal(route, ref)
        for a, b in zip(route, route[1:]):
            for pad in used.keys() - set(wire['pads']):
                assert not segment_hits_box(a,b,(*pad_xy(pad),0,0),0.3), f'{ref} passes over {pad}'
            axis = 0 if abs(a[1]-b[1]) < 1e-6 else 1
            lane = a[1-axis]
            lo, hi = sorted((a[axis],b[axis]))
            for other, other_axis, other_lane, other_lo, other_hi in routed_segments:
                if axis == other_axis and min(hi,other_hi) - max(lo,other_lo) > 1e-6:
                    assert abs(lane-other_lane) >= 0.6, f'Crowded parallel routes: {ref}/{other}'
            routed_segments.append((ref,axis,lane,lo,hi))
    for p in d['parts']:
        assert p['side']=='top', f'Component not on top: {p["ref"]}'
        for pin,route in component_routes(p).items():
            orthogonal(route,p['ref']+'.'+pin)
            assert all(0<=xy[0]<=38.1 and 0<=xy[1]<=50.8 for xy in route), f'Off-board lead: {p["ref"]}'
            if p.get('style')=='transistor':
                assert math.dist(route[-1],pad_xy(p['pins'][pin]))<1e-6, f'Lead endpoint: {p["ref"]}.{pin}'
            else:
                endpoints=list(p['pins'].values())
                assert math.dist(route[0],pad_xy(endpoints[0]))<1e-6 and math.dist(route[-1],pad_xy(endpoints[1]))<1e-6, f'Lead endpoint: {p["ref"]}'
    # Nominal body rectangles are a layout check, not certified manufacturer/socket clearance.
    for i,p in enumerate(d['parts']):
        x,y,w,h=p['body'];assert x-w/2>=0 and x+w/2<=38.1 and y-h/2>=0 and y+h/2<=50.8,p['ref']
        for q in d['parts'][i+1:]:
            if p['side']!=q['side']:continue
            xx,yy,ww,hh=q['body']
            assert abs(x-xx)>=(w+ww)/2 or abs(y-yy)>=(h+hh)/2, f'Body overlap: {p["ref"]}/{q["ref"]}'
    for w in d['jumpers']:
        for p in d['parts']:
            if p['side']=='bottom':
                assert not any(segment_hits_box(a,b,p['body']) for a,b in zip(w['route'],w['route'][1:])),f'Jumper {w["ref"]} crosses body {p["ref"]}'
    for p in d['parts']:
        for route in component_routes(p).values():
            for q in d['parts']:
                if q['ref']==p['ref'] or q['side']!=p['side']:continue
                assert not any(segment_hits_box(a,b,q['body']) for a,b in zip(route,route[1:])), f'Lead {p["ref"]} crosses body {q["ref"]}'
    print('Current layout: connected nets; no shorts or pad reuse; all bodies on top; all routes orthogonal; nominal bodies and other-component lead clearances checked.')


class Svg:
    def __init__(self):
        self.s=['<svg xmlns="http://www.w3.org/2000/svg" width="1760" height="1300" viewBox="0 0 1760 1300">','<title>Complete proposed Sony interface placement: separate top and mirrored underside</title>','<rect width="1760" height="1300" fill="#f8fafc"/>','<style>text{font-family:Arial,sans-serif;fill:#172033}</style>']
    def text(self,x,y,t,size=16,color='#172033',anchor='start'):
        self.s.append(f'<text x="{x}" y="{y}" font-size="{size}" text-anchor="{anchor}" style="fill:{color}">{html.escape(str(t))}</text>')
    def rect(self,x,y,w,h,fill,stroke='none',radius=0,dash=False):
        self.s.append(f'<rect x="{x}" y="{y}" width="{w}" height="{h}" rx="{radius}" fill="{fill}" stroke="{stroke}"'+(' stroke-dasharray="6 4"' if dash else '')+'/>')
    def circle(self,x,y,r,fill,stroke='none'):
        self.s.append(f'<circle cx="{x}" cy="{y}" r="{r}" fill="{fill}" stroke="{stroke}"/>')
    def path(self,points,color,width=2,dash=False):
        orthogonal(points,'SVG path')
        path='M'+' L'.join(f'{x:.2f},{y:.2f}' for x,y in points)
        self.s.append(f'<path d="{path}" fill="none" stroke="{color}" stroke-width="{width}" stroke-linejoin="round"'+(' stroke-dasharray="5 4"' if dash else '')+'/>')
    def finish(self):
        data='\n'.join(self.s+['</svg>'])+'\n';ET.fromstring(data);return data


def draw(d):
    s=Svg();scale=15
    s.text(35,43,'Sony remote + Camera 1 · BOARD COMPONENTS',29)
    s.text(35,74,'MCP41050 + HCT125 + LCC110 · proposed no-cut ElectroCookie Mini layout',18)
    s.rect(35,94,1690,66,'#fff3cd',radius=8)
    s.text(52,120,'CHECKED PAD ALLOCATION · VERIFY CLEARANCE IN THE FINAL ENCLOSURE',18,'#92400e')
    s.text(52,145,'Components on top. Headers and 12 wire pieces underneath. Circles also show where opposite-face leads and wires land.',16,'#92400e')
    for side,bx in [('top',55),('bottom',705)]:
        by=220
        def pos(pt):return (bx+(38.1-pt[0] if side=='bottom' else pt[0])*scale,by+pt[1]*scale)
        def pad(p):return pos(pad_xy(p))
        s.text(bx,191,'TOP · component view' if side=='top' else 'UNDERSIDE · board flipped left-to-right',21)
        s.rect(bx,by,38.1*scale,50.8*scale,'#e6edf3','#94a3b8',14)
        for row in range(1,18):
            for col in 'ABCDEFGHIJ':
                x,y=pad(col+str(row));s.circle(x,y,4,'#fff','#8a9aaa')
            s.text(bx+8,pad('A'+str(row))[1]+4,row,11)
        for col in 'ABCDEFGHIJ':s.text(pad(col+'1')[0],by+28,col,12,anchor='middle')
        if side=='bottom':
            for part in d['parts']:
                for location in part['pins'].values():
                    s.circle(*pad(location),5,'#d8b5df')
        if side=='top':
            for wire in d['jumpers']:
                for location in wire['pads']:
                    s.s.append(f'<circle cx="{pad(location)[0]}" cy="{pad(location)[1]}" r="5" fill="{COLORS[wire['net']]}" opacity="0.35"/>')
        if side=='bottom':
            for w in d['jumpers']:
                points=[pos(pt) for pt in w['route']];color=COLORS[w['net']]
                # White edging keeps insulated crossing wires visually separate.
                s.path(points,'#f8fafc',5);s.path(points,color,2.5)
                for p in w['pads']:
                    x,y=pad(p);s.circle(x,y,4,color)
                x,y=points[0];s.text(x+5,y-7,w['ref'],10,color)
        if side=='top':
            for c in d['contacts']:
                s.circle(*pad(c['pad']),5,'#8cbec7')
        for p in d['parts']:
            if p['side']!=side:continue
            ref=p['ref'];style=p.get('style','dip');cx,cy,bw,bh=p['body'];x,y=pos((cx,cy))
            if style=='dip':
                color={'U1':'#0f766e','U2':'#1d4ed8','K1':'#7c3aed'}[ref]
                s.rect(x-bw*scale/2,y-bh*scale/2,bw*scale,bh*scale,color,radius=5)
                s.text(x,y,ref,19,'#fff','middle');s.circle(*pos((cx-2,cy-bh/2+1)),3,'#fff')
                for n,location in p['pins'].items():
                    xx,yy=pad(location);edge=x-bw*scale/2 if location[0]=='E' else x+bw*scale/2
                    s.path([(xx,yy),(edge,yy)],color)
                    s.text(xx+(-12 if location[0]=='E' else 12),yy+4,n,10,color,'middle')
                continue
            if style=='transistor':
                routes=p['lead_routes']
                for name,points in routes.items():
                    s.path([pos(pt) for pt in points],'#374151',2)
                    xx,yy=pad(p['pins'][name]);s.text(xx-5,yy-7,name,10)
                s.rect(x-2.5*scale,y-2.5*scale,5*scale,5*scale,'#334155',radius=12)
                s.text(x,y+5,ref,15,'#fff','middle');continue
            pins=list(p['pins'].values())
            route=p.get('lead_route',[pad_xy(pins[0]),pad_xy(pins[1])])
            s.path([pos(pt) for pt in route],'#926329',2.5)
            if style=='axial':
                # Filled body lies on the stated lead route, not over a second component.
                angle=p['angle']*(-1 if side=='bottom' else 1)
                s.s.append(f'<rect x="{-3.4*scale}" y="{-1.3*scale}" width="{6.8*scale}" height="{2.6*scale}" rx="5" fill="#f1cf85" stroke="#815a21" transform="translate({x},{y}) rotate({angle})"/>')
                s.text(x+(35 if ref=='R1' else -25),y-12,ref,17,'#815a21')
            elif style=='upright':
                s.circle(x,y,1.3*scale,'#f1cf85','#815a21');s.text(x-26,y+6,ref,15,'#815a21')
            elif style=='ceramic':
                s.rect(x-bw*scale/2,y-bh*scale/2,bw*scale,bh*scale,'#c77c29',radius=9)
                s.text(x-50,y+5,ref,15,'#8b4f13')
            elif style=='electrolytic':
                s.circle(x,y,2.5*scale,'#1e293b');s.text(x,y+5,ref,15,'#fff','middle')
                xx,yy=pad(p['pins']['+']);s.text(xx+12,yy+8,'+',18,'#dc2626')
                xx,yy=pad(p['pins']['-']);s.text(xx+12,yy+8,'−',18,'#172033')
        for c in d['contacts']:
            x,y=pad(c['pad'])
            if side=='bottom':
                s.rect(x-8,y-8,16,16,'#0e7490',radius=2)
            s.text(x+9,y-8,c['ref'].replace('J',''),10,'#0e7490')
        if side=='top':
            s.text(bx,1010,'Cyan circles: header tails. Other colored circles: underside wire pads.',14,'#0e7490')
        else:
            s.text(bx,1008,'Purple circles: top component joints. Colored wire dots: underside joints.',14,'#a21caf')
            s.text(bx,1028,'Cyan squares: underside header pins. Pad IDs stay the same after flipping.',14,'#0e7490')
    x=1325;s.text(x,195,'TOP',20)
    top_legend = [
        'U1   MCP41050-I/P',
        'U2   SN74HCT125N',
        'K1   LCC110',
        'Q1   2N3904BU, formed leads',
        f'R1   {RESISTORS["R1"]} Ω, upright',
        f'R2   {RESISTORS["R2"]/1000:g} kΩ   /   R3   {RESISTORS["R3"]/1000:g} kΩ, outer edges',
        f'R4–R9   {RESISTORS["R4"]/1000:g} kΩ each',
        'C1/C2   100 nF ceramic, either orientation',
        'C3   10 µF electrolytic, + J6 / − J10',
    ]
    for i,t in enumerate(top_legend):s.text(x,226+i*25,t,16)
    s.text(x,450,'UNDERSIDE',20)
    for i,t in enumerate(['No component bodies underneath.','BG1–BG6   six ground jumpers','BV1/BV2   two power wires, 4 pads','W10–W13   four signal wires','12 pieces; 24 solder landings.','Crossings are insulated and have no joint.']):s.text(x,481+i*27,t,16)
    s.text(x,690,'J1 · seven controller jumpers',18)
    contacts = {c['ref']: c['pad'] for c in d['contacts']}
    j1_signals = ['GND', '+5 V', 'SCK', 'MOSI', 'CS', 'ENABLE', 'SPARE GND', 'CAMERA']
    for pin, signal in enumerate(j1_signals, start=1):
        s.text(x,687+pin*23,f'{pin} {signal} → {contacts[f"J1.{pin}"]}',16)
    s.text(x,910,'J2 · Sony pigtail',18)
    s.text(x,939,f'1 Input 1 → {contacts["J2.1"]}',16)
    s.text(x,966,f'2 ST Remote GND → {contacts["J2.2"]}',16)
    s.text(x,993,f'3 {contacts["J2.3"]} → inline R10 1 kΩ → EXT IN 1',14)
    s.rect(35,1040,1690,216,'#e2e8f0',radius=10)
    notes=[
      'No copper cuts. No shared component/jumper holes.',
      'R1/R4–R8 stand upright; Q1 leads land at B12 (E), B13 (B), B16 (C). Insulate formed leads and check actual transistor marking.',
      'R1 returns to F13 through the gap between U2 and K1. BV2 lands at G13. Check actual socket clearance.',
      'C1/C2 leads need careful forming. C3 negative stripe goes to J10 (GND). R10 1 kΩ is sleeved inline in the camera cable; it is not a board component.',
      'Each underside wire has two through-hole ends. Sleeve the full span between joints.',
      'Nominal body envelopes do not certify sockets, mounting holes or final height. Dry-fit the actual board before soldering.',
      'See pad-map.md for component terminals and internal-jumpers.svg for the seven wires to the XIAO breakout.',
    ]
    for i,t in enumerate(notes):s.text(52,1070+i*26,t,16)
    return s.finish()


def tables(d):
    s=['# Sony interface pad allocation','', 'The [component placement image](placement-full.svg) shows the top and horizontally mirrored underside. See the [bench results](../../docs/bench-results-2026-11-05.md) for observed hardware behavior and the [circuit guide](../../docs/sony-interface.md) for installation limits.','', '## Component terminals','', '| Ref | Part / side | Terminal → pad |','| --- | --- | --- |']
    for p in d['parts']:s.append(f'| {p["ref"]} | {p["part"]} / {p["side"]} | '+', '.join(f'{n} → {pad}' for n,pad in p['pins'].items())+' |')
    s+=['','## Underside header pins','', 'J1 lands in columns B and I; J2 lands in column H. Insert header pins from underneath and solder their tails from the top. Use individual pins at spaced pads and a two-pin header at H4–H5. Use the [consolidated jumper image](../internal-jumpers.svg) for the seven J1 wires to the XIAO breakout. J1.7 at B9 is spare ground. Sony Input 2 stays insulated.','', '| Contact | Net | Pad |','| --- | --- | --- |']
    for c in d['contacts']:s.append(f'| {c["ref"]} | {c["net"]} | {c["pad"]} |')
    s+=['','## Camera output cable','', f'J2.3 at {next(c["pad"] for c in d["contacts"] if c["ref"] == "J2.3")} is the buffer output. Insert R10 (1 kohm) in series in this pigtail, sleeve both joints and the resistor, then connect to EXT IN 1. R10 is outside the board geometry model. Never connect this lead to vehicle 12 V.','', '## Underside wire pieces and bus taps','', 'Crossings are not junctions. Use insulated wire; route clear of resistor bodies and keep leads sleeved over unrelated pads. Coordinates are endpoint and routing references, not validated three-dimensional wire bends.','', '| Wire | Net | Solder pads in order |','| --- | --- | --- |']
    for w in d['jumpers']:s.append(f'| {w["ref"]} | {w["net"]} | '+ ' → '.join(w['pads'])+' |')
    s+=['', 'Use one insulated through-hole jumper per listed pair. Each end has its own hole.', '', '## Assembly and physical conditions','',
        '- Fit sockets and top components first, without solder. The IC-only image is now a subset of this candidate.',
        '- R1 and R4–R8 stand upright. R1 is at C15 and its sleeved return lead follows the gap between U2 and K1 to F13. The power bus now ends at G13. This is a formed-lead proposal, not a validated socket clearance or guaranteed supplied lead length.',
        '- Q1 has a formed-lead footprint, not the default three adjacent TO-92 holes. E=B12, B=B13, C=B16. Q1 moves to the lower-left corner; R7 runs straight along C12–C13. Check the actual part orientation and preform without force at the body.',
        '- All component bodies are now on top. R2 follows the top left edge; R3 follows the top right edge with a jog to x=37 mm past C3. Sleeve extended leads and dry-fit before trimming.',
        '- Check supplied lead lengths before trimming. If a lead cannot follow its proposed route safely, revise the model or use an insulated extension; do not force the component.',
        '- C1/C2 leads are spread to the listed pads, rather than matching the stock 2.5 mm lead pitch. Avoid stress at the ceramic coating. C3 is polarized.',
        '- Body envelopes are provisional. The resistor envelope allows 6.8 × 2.6 mm, based on Yageo MFR-25 maximum body dimensions. Socket outlines, capacitor lead availability, mounting-hole locations and assembled height still require actual measurements.',
        '- All component bodies are on top; only the 12 wire pieces and solder joints are underneath. Distributed pigtails preserve the no-cut board. Mounted height and center mounting-hole access remain unverified.',
        '- On the actual board, verify A–E / F–J strip continuity and orientation first. Do not solder until the dry-fit and receiver-disconnected electrical checks pass.',
        '', '## Verification scope','',
        '`python3 scripts/full-placement.py --check` verifies the 16 board component references, terminal connectivity against an independent device-pin contract, all resistor values, factory strips, no accidental net joins, no reused holes, pigtail assignments, nominal body separation, all-top component placement, orthogonal routes, and all component-lead routes avoiding other component bodies. It also verifies that the SVG/table match the model. This is not a timing, analog-current, power-sequencing or physical-fit simulation.',
        '', 'Regenerate with `python3 scripts/full-placement.py`. Tests deliberately introduce a rail short, an open jumper, a transistor-pin swap, pad reuse, a resistor-value error, a body overlap a missing bus tap, a diagonal wire, and a component lead crossing another body.',
        '', 'Source for resistor envelope: [Yageo MFR datasheet, dimensions](https://yageogroup.com/content/datasheet/asset/file/YAGEO-MFR_DATASHEET). Other envelopes are conservative drawing assumptions, not new manufacturer guarantees.','']
    return '\n'.join(s)


def main():
    parser=argparse.ArgumentParser(description=__doc__);parser.add_argument('--check',action='store_true');args=parser.parse_args()
    d=json.loads((FOLDER/'layout.json').read_text());check(d)
    for name,data in {'placement-full.svg':draw(d),'pad-map.md':tables(d)}.items():
        p=FOLDER/name
        if args.check:assert p.read_text()==data,f'Regenerate {name}'
        else:p.write_text(data)
    print('Generated files match.' if args.check else 'Wrote placement-full.svg and pad-map.md.')


if __name__=='__main__':main()
