dorkusprime/miata-remote-control-knob/scripts/gesture-monitor.py

#!/usr/bin/env python3
"""Render controller JSONL events live. Does not flash or reset the board."""
import argparse
import datetime
import json
import pathlib
import select
import sys
import time

ROOT = pathlib.Path(__file__).resolve().parents[1]
MAX_LINE = 4096
LABELS = {
    "volume_up": "Volume up",
    "volume_down": "Volume down",
    "play_pause": "Play / pause requested",
    "mute_att": "Mute requested",
    "next_track": "Next track",
    "previous_track": "Previous track",
    "camera_on": "Manual camera request: ON",
    "camera_off": "Manual camera request: OFF",
    "long_press_ignored": "Long press ignored (unassigned)",
    "learning_toggle": "Learning mode toggled (watch amber/blue flashes)",
}


def clean(text):
    return "".join(c for c in str(text) if c.isprintable())[:500]


class Lines:
    """Bounded framing; discard oversized messages through their next newline."""
    def __init__(self):
        self.buffer = bytearray()
        self.dropping = False

    def feed(self, chunk):
        for byte in chunk:
            if byte == 10:
                if not self.dropping and self.buffer:
                    yield self.buffer.decode("utf-8", errors="replace").rstrip("\r")
                self.buffer.clear()
                self.dropping = False
            elif not self.dropping:
                self.buffer.append(byte)
                if len(self.buffer) > MAX_LINE:
                    self.buffer.clear()
                    self.dropping = True


class Renderer:
    def __init__(self, raw=False, outputs=False):
        self.raw = raw
        self.outputs = outputs
        self.last_state = None
        self.warned_legacy = False

    def render(self, line):
        try:
            event = json.loads(line)
        except (ValueError, TypeError):
            if self.raw:
                return "[raw] " + clean(line)
            if not self.warned_legacy:
                self.warned_legacy = True
                return "Non-JSON output received; flash the controller sketch for gesture translation."
            return None
        if not isinstance(event, dict) or type(event.get("v")) is not int or event.get("v") != 1:
            return "Unsupported device message."
        kind = event.get("type")
        if kind == "gesture":
            action = event.get("action")
            if not isinstance(action, str) or action not in LABELS:
                return "Unknown gesture action."
            steps = event.get("steps")
            if type(steps) is not int or not 1 <= steps <= 65536:
                return "Invalid gesture step count."
            simulated = event.get("simulated")
            if type(simulated) is not bool:
                return "Gesture message missing simulation marker; ignored."
            if not simulated and type(event.get("accepted")) is not bool:
                return "Hardware gesture missing acceptance marker; ignored."
            label = LABELS[action]
            if action in ("volume_up", "volume_down", "next_track", "previous_track"):
                label += f" × {steps}"
            prefix = "[SIM] " if simulated else ("[REQUEST] " if event["accepted"] else "[DROPPED] ")
            if not simulated and event.get("flick_tail") is True:
                prefix = "[FLICK TAIL] "
            elif not simulated and event.get("flick_trigger") is True and event["accepted"]:
                prefix = "[FLICK TRIGGER] "
            code = event.get("pot_code")
            if not simulated and type(code) is int and 0 <= code <= 255:
                label += f" (code {code})"
            device_ms = event.get("ms")
            if self.outputs and not simulated and type(device_ms) is int and 0 <= device_ms <= 0xffffffff:
                label += f" @{device_ms}ms"
            return prefix + label
        if kind == "output":
            if not self.outputs:
                return None
            fields = ("edge_ms", "code", "pending", "input_age_ms", "trace_lost")
            if (type(event.get("on")) is not bool or
                    any(type(event.get(n)) is not int or not 0 <= event[n] <= 0xffffffff for n in fields) or
                    event["code"] > 255):
                return "Invalid output trace."
            age = event["input_age_ms"]
            age_text = "no audio gesture yet" if age == 0xffffffff else f"{age}ms since last audio gesture"
            return (f"[OUTPUT @{event['edge_ms']}ms] " + ("PRESS" if event["on"] else "RELEASE") +
                    f" code={event['code']} pending={event['pending']}; {age_text}" +
                    (f"; LOST {event['trace_lost']} trace edges" if event["trace_lost"] else ""))
        if kind == "bulk":
            if (type(event.get("direction")) is not int or event["direction"] not in (-1, 1) or
                    type(event.get("target_steps")) is not int or not 1 <= event["target_steps"] <= 100 or
                    any(type(event.get(n)) is not int for n in ("sent_net", "remaining_steps")) or
                    type(event.get("accepted")) is not bool):
                return "Invalid bulk message."
            direction = "up" if event.get("direction", 0) > 0 else "down"
            return (f"[BULK] Volume {direction}: target={event.get('target_steps')} steps; "
                    f"sent net={event.get('sent_net')}; remaining={event.get('remaining_steps')}; "
                    f"{'accepted' if event.get('accepted') else 'DROPPED'}")
        if kind == "timing":
            if any(type(event.get(n)) is not int or not 5 <= event[n] <= 250 for n in ("press_ms", "gap_ms")):
                return "Invalid timing message."
            boost = event.get("boost_steps")
            enabled = event.get("outputs_enabled")
            if boost is not None and (type(boost) is not int or not 1 <= boost <= 20):
                return "Invalid timing message."
            if enabled is not None and type(enabled) is not bool:
                return "Invalid timing message."
            return (f"Pulse timing (RAM only): press={event['press_ms']}ms, release gap={event['gap_ms']}ms" +
                    (f", fast flick={boost} steps" if boost is not None else "") +
                    ("; outputs " + ("enabled" if enabled else "SUSPENDED (enter enable)") if enabled is not None else ""))
        if kind == "calibration":
            codes = event.get("codes")
            names = ("volume_up", "volume_down", "play_pause", "mute_att", "next_track", "previous_track")
            if isinstance(codes, dict) and "play_pause" not in codes:
                names = tuple(n for n in names if n != "play_pause")  # v3.4 console compatibility
            if not isinstance(codes, dict) or any(type(codes.get(n)) is not int or not 0 <= codes[n] <= 255 for n in names):
                return "Invalid calibration message."
            return "Codes (RAM only): " + ", ".join(f"{n}={codes[n]}" for n in names)
        if kind == "status":
            return clean(event.get("message", ""))
        if kind == "heartbeat":
            state = (event.get("connected"), event.get("camera_preview"),
                     event.get("simulated", True), event.get("outputs_enabled", False),
                     event.get("learning_mode", False))
            if any(type(value) is not bool for value in state):
                return "Invalid device state."
            if state == self.last_state:
                return None
            self.last_state = state
            return ("Twist " + ("connected" if state[0] else "missing") +
                    "; camera request " + ("ON" if state[1] else "OFF") +
                    ("; outputs simulated" if state[2] else
                     "; hardware outputs " + ("enabled" if state[3] else "disabled")) +
                    ("; LEARNING MODE" if state[4] else ""))
        if kind == "input" and self.raw:
            return "[input] " + clean(json.dumps(event, separators=(",", ":")))
        return None


def output(message):
    if message:
        stamp = datetime.datetime.now().strftime("%H:%M:%S.%f")[:-3]
        print(f"{stamp}  {message}", flush=True)


def serial_modules():
    lock = json.loads((ROOT / "firmware/toolchain.json").read_text())
    bundled = (ROOT / ".tools/arduino/data/packages/rp2040/hardware/rp2040" /
               lock["core_version"] / "tools/pyserial")
    if not bundled.is_dir():
        raise RuntimeError("Toolchain missing; run python3 scripts/setup-toolchain.py first.")
    sys.path.insert(0, str(bundled))
    import serial
    from serial.tools import list_ports
    return serial, list_ports


def choose_port(explicit, list_ports):
    if explicit:
        return explicit
    candidates = [p.device for p in list_ports.comports()
                  if p.vid == 0x2E8A and p.pid is not None and (p.pid & 0x00FF) == 0x000A]
    if len(candidates) > 1:
        raise RuntimeError("Multiple RP2040 serial devices; select one with --port.")
    return candidates[0] if candidates else None


def monitor(args):
    serial, ports = serial_modules()
    announced_wait = False
    while True:
        port = choose_port(args.port, ports)
        if port is None:
            if not announced_wait:
                output("Waiting for XIAO USB serial port; Ctrl+C exits.")
                announced_wait = True
            time.sleep(1)
            continue
        try:
            # Configure before opening; never use the 1200-baud reset sequence.
            with serial.Serial(port=None, baudrate=115200, timeout=0.2,
                               write_timeout=1, exclusive=True) as connection:
                connection.port = port
                connection.dtr = True
                connection.rts = True
                connection.open()
                announced_wait = False
                if args.interactive:
                    # Discard commands entered before connection; never replay them.
                    while select.select([sys.stdin], [], [], 0)[0]:
                        if not sys.stdin.readline(): return
                output(f"Connected to {port}; awaiting firmware status. Ctrl+C exits.")
                connection.write(b"h\n")
                if args.interactive:
                    output("Enter commands: codes; set ACTION 0..255; probe 0..255; timing PRESS GAP; flick [first/second MIN MAX | third MIN | gap/window/quiet MS | steps N | on/off]; learn ACTION; enable; release. Ctrl+C exits.")
                renderer, lines = Renderer(args.raw, args.outputs), Lines()
                while True:
                    if args.interactive and select.select([sys.stdin], [], [], 0)[0]:
                        line = sys.stdin.readline()
                        if not line: return
                        command = line.rstrip("\r\n")
                        if command and len(command) <= 47 and all(32 <= ord(c) <= 126 for c in command):
                            connection.write((command + "\n").encode("ascii"))
                        elif command:
                            output("Command must be ASCII and at most 47 characters; nothing sent.")
                    chunk = connection.read(min(connection.in_waiting or 1, 512))
                    if not chunk and not pathlib.Path(port).exists():
                        raise serial.SerialException("USB serial port disappeared")
                    for line in lines.feed(chunk):
                        output(renderer.render(line))
        except (serial.SerialException, OSError) as error:
            output(f"Serial connection unavailable: {clean(error)}; retrying. Close other monitors.")
            time.sleep(1)


def main():
    parser = argparse.ArgumentParser(description=__doc__)
    parser.add_argument("--port", help="Serial port; otherwise detect the sole matching XIAO/RP2040")
    parser.add_argument("--interactive", action="store_true", help="Also send commands typed into this terminal")
    parser.add_argument("--outputs", action="store_true", help="Show timestamped GPIO output edges and queue depth")
    parser.add_argument("--raw", action="store_true", help="Also show raw input samples and legacy text")
    parser.add_argument("--stdin", action="store_true", help="Render JSONL from stdin instead of a device")
    args = parser.parse_args()
    try:
        if args.stdin:
            renderer, lines = Renderer(args.raw, args.outputs), Lines()
            while chunk := sys.stdin.buffer.read1(512):
                for line in lines.feed(chunk):
                    output(renderer.render(line))
        else:
            monitor(args)
    except KeyboardInterrupt:
        print("\nMonitor closed.", flush=True)
    except RuntimeError as error:
        parser.exit(1, str(error) + "\n")


if __name__ == "__main__":
    main()
