dorkusprime/miata-remote-control-knob/(commit log)

2026-10-27 Document knob hardware, wiring plan, and development milestones
2026-10-27 Document included Sony steering remote adapter
2026-10-27 Diagnose missing rotation with checked absolute counter snapshots
    [diagnostic.ino]
2026-10-27 Prepare Picotool USB maintenance and record working encoder tests
2026-10-27 Add full-brightness idle and transient gesture LED feedback
2026-10-27 Record user-confirmed LED feedback bench results
2026-10-27 Design isolated Sony resistor-ladder prototype and receiver-free bench checks
    [bom.csv]
2026-10-27 Continue SOIC-8 prototype with Amazon candidates and soldering practice guide
2026-10-27 Consolidate through-hole Sony interface documentation and archive prior designs
    [bom.csv]
2026-10-27 Add current-design DIP placement study and pin reference
2026-10-27 Add all-component Sony interface placement with checked pad map and separate board views
2026-10-27 Simplify placement to one underside resistor and two tapped power buses
2026-10-27 Move R1 to top and enforce orthogonal component and wire routing
2026-10-29 Integrate compact camera trigger and record Sony bench acceptance
    [bom.csv]
2026-10-29 Record observed Sony steering remote learning functions
2026-11-03 Show resistor values in placement diagram
2026-11-03 Mark capacitor polarity on placement diagram
2026-11-03 Group harness wire landings into columns
2026-11-03 Match placement diagram to revised resistor columns
2026-11-03 Show underside headers and solder access points
2026-11-03 Mark underside wire pads on top placement view
2026-11-04 Route ground bus clear of H4 header pad
2026-11-04 Separate ground jumper ends at row four
2026-11-04 Separate power and ground crossing from I6
2026-11-04 Separate power bend from wiper jumper
2026-11-04 Give row-six power jumpers separate holes
2026-11-04 Clean up underside jumper routing and enforce pad clearance
    [full-placement.py]
2026-11-05 Move power jumper endpoint from H13 to G13
2026-11-06 Add gated bench diagnostic for assembled Sony interface
2026-11-06 Integrate knob gestures with tested Sony interface driver
2026-11-06 Add knob-operated Sony learning mode with LED feedback
2026-11-06 Report which Twist initialization check fails
    [controller.ino]
2026-11-06 Extend steering learning holds to six seconds
2026-11-06 Add five voltage-spaced Sony commands and live calibration console
2026-11-06 Use current official Picotool and Tahoe-compatible libusb on macOS
2026-11-06 Delegate uploads to Arduino CLI core recipe and remove custom reset orchestration
2026-11-06 Record all five Sony commands working and next capacity probe
2026-11-06 Trace relay GPIO edges and queue depth to diagnose volume tail latency
2026-11-09 Document project box wiring and XIAO breakout pin translation
2026-11-11 Document P1 harness and internal jumper wire colors
